rzelko/Feather-nRF52840-Quadcopter/IMG_7096_S.jpg

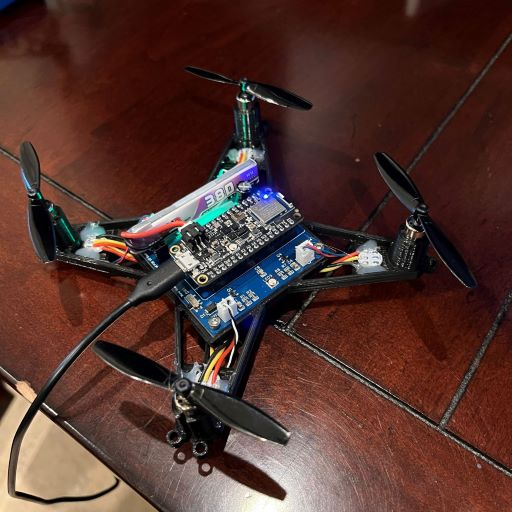
IMG_7096_S.jpg
