rzelko/Feather-nRF52840-Quadcopter/Schematic_Nano Quadcopter V7 Rev1_2022-06-19.pdf

A | A

1

2

3

4

5

JST_2PIN-THM
M1

2

1

JST_2PIN-THM

M2

1
2

JST_2PIN-THM

M3

1
2
JST_2PIN-THM
M4

2

1

While the TOF sensor VL6180X (distance 0-20cm) would aid at landing and taking off, VL53L0X (distance 5-100cm) could be used for both of these (with some assumptions) and also hovering within up to 1m altitude.

## Altitude Sensor

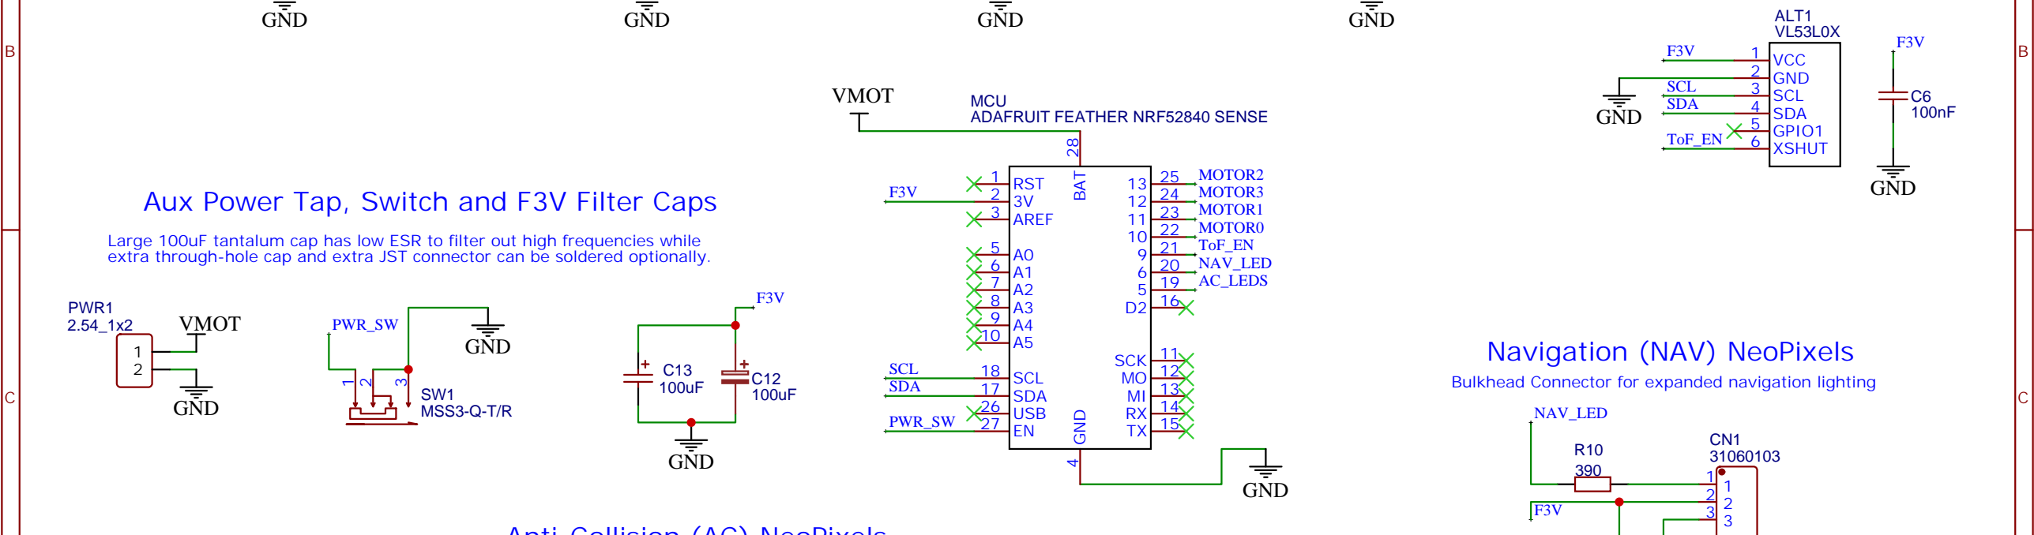
[picture p2: figure]
VMOT; GND; ADAFRUIT FEATHER NRF52840 SENSE; MCU; RST 1 3V 2 AREF 3; SCK 11 MO 12 MI 13 RX 14 TX 15; USB 26 EN 27; SDA 17 SCL 18; 4 BAT 28; ALT1; VCC 1 GND 2 SCL 3 SDA 4 GPIO1 5 XSHUT 6; PWR1; MSS3-Q-T/R; PWR_SW; MOTOR0; MOTOR1; MOTOR3; MOTOR2; SCL SDA; AC_LEDS; NAV_LED; Navigation (NAV) NeoPixels; ToF_EN

According to documentation of WS2812B we need 100nF decoupling capacitors placed next to each pixel. According to Adafruit Guidelines we need to place a resistor of value 300 to 500 Ohm in between Arduino and the input of the first neopixel, it has to be placed close to the Neopixel rather than Arduino. Large decoupling capacitor should be placed next to the supply. One pixel will be place on each side on top and bottom.

## Anti-Collision (AC) NeoPixels

### VMOT

### GND

### VMOT

100

R6

10K

R5

22uF

C3

### VMOT

### GND

### VMOT

100

R8

10K

R7

22uF

C4

### VMOT

### GND

### VMOT

100

R4

10K

R3

22uF

C2
22uF

C1

10K

R1

100

R2

### VMOT

### GND

## Motor and PWM based MOSFET controllers

Resistor between MOTORX and Gate prevents in-rush currents. The combination of this resistance and gate capacitance will slow down the change current thus removing the power supply ripple. The resistor between Gate and GND guarantees turned off transistors during power-up. Freewheeling snubber diode allows the opposing current from the motor coil to flow when the motors are being turned off. Note the motor connector polarity, which changes for every second motor.

Large 100uF tantalum cap has low ESR to filter out high frequencies while extra through-hole cap and extra JST connector can be soldered optionally.

## Aux Power Tap, Switch and F3V Filter Caps

### VMOT

100nF

C11

AO3400A

Q1

SS34

D1
SS34

D2
SS34

D3
SS34

D4

AO3400A

Q2
AO3400A

Q3
AO3400A

Q4

MOTOR0 | MOTOR1
MOTOR3 | MOTOR2

Bulkhead Connector for expanded navigation lighting

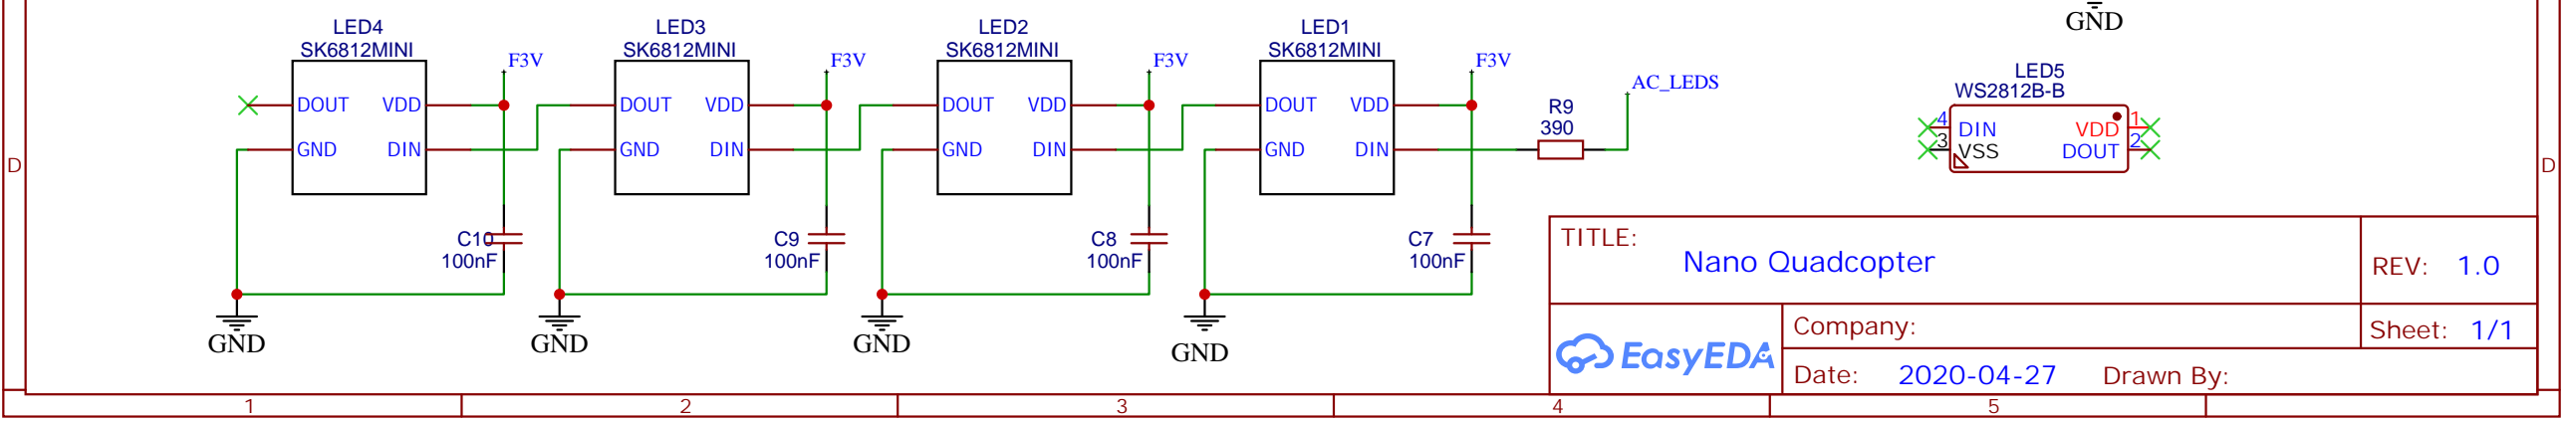
[picture p3: figure]
TITLE:; Nano Quadcopter; REV: 1.0; Date:; Sheet: 1/1; Drawn By:; Company:; LED5; DIN 4; VSS 3; DOUT 2; VDD 1; GND; SK6812MINI; LED1; DOUT; DIN; VDD; LED2; LED3; LED4; AC_LEDS
