rzelko/Feather-nRF52840-Quadcopter/Schematic_Nano Quadcopter V5 Rev0_2021-04-27.png

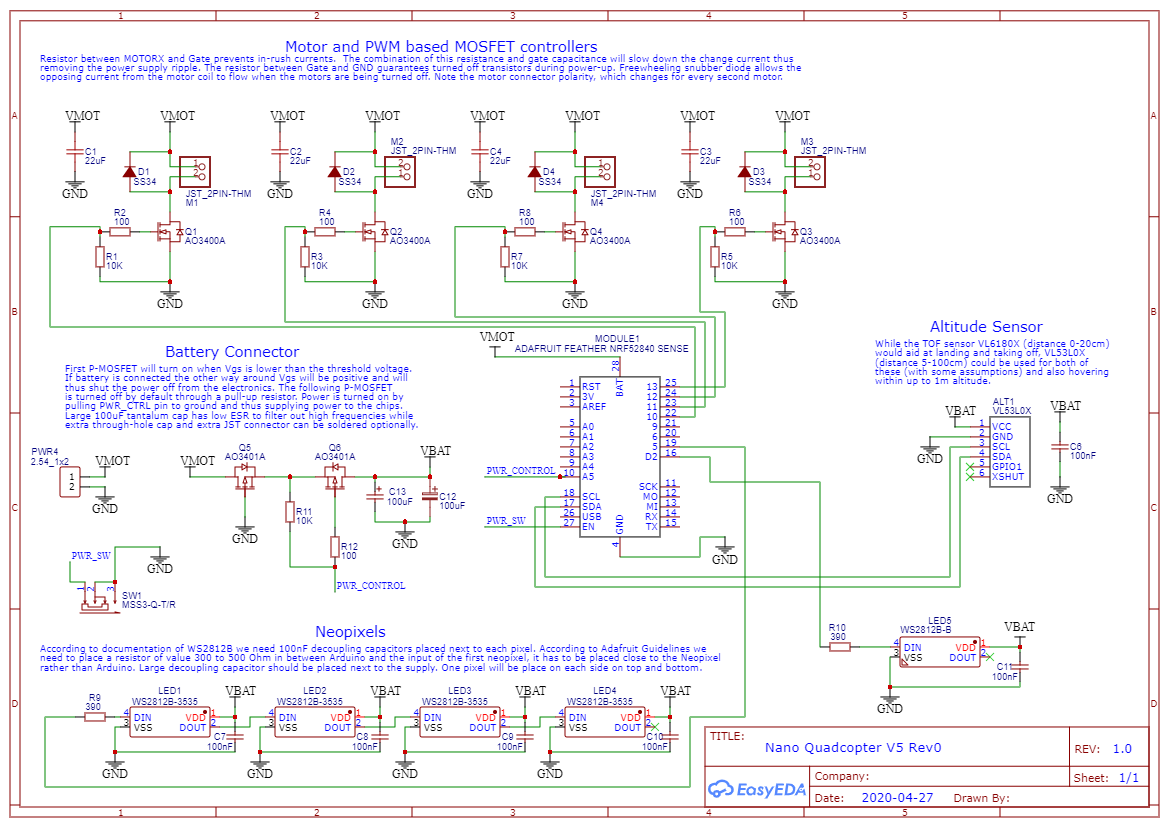
Schematic_Nano Quadcopter V5 Rev0_2021-04-27.png
